andreasschoeler93/Stoppuhr-2.0-Ladekoffer/docs/Stoppuhr_2_0_Ladeplatine_Bestellliste.xlsx

Sheet: Reichelt-Bestellung
STOPPUHR 2.0 | LADEPLATINE · REICHELT
23 bestellbare Reichelt-Positionen • 10 Ladekanäle • Sonderbauteile stehen separat im Blatt »Noch offen«
Nr. | Reichelt-Artikel-Nr. | Anzahl | Bauteil / Artikel | KiCad-Referenz | Bauform / Raster | Hinweise zur Kompatibilität | Produktlink | Richtpreis €/Stk.* | Zwischensumme €*
1 | X7R-5 4,7N MUR | 10 | 4,7 nF, X7R, THT, RM 5,0 mm | C-DIV_1–10 | P5,0 / Scheibenkondensator | RM passt; maximale Breite/Dicke gegen D4,3 × W1,9 mm prüfen. | https://www.reichelt.de/de/de/shop/produkt/vielschicht-keramikkondensator_4_7n_10_-22871 | 0.10 € | 1.00 €
2 | RAD 100/25 | 1 | Elko 100 µF / 25 V, radial | C1 | D6,3 / H11 / P2,5 | Gehäuse 6,3 × 11 mm; Polung beim Einbau beachten. | https://www.reichelt.de/de/de/shop/produkt/elko_radial_100_f_25_v_rm_2_5_85_c_2000h_20_-15102 | 0.04 € | 0.04 €
3 | X7R-5 100N | 5 | 100 nF, X7R, THT, RM 5,0 mm | C3–C7 | P5,0 / Scheibenkondensator | 5 Stück zusammengefasst; Bauteilkörperbreite/Dicke prüfen. | https://www.reichelt.de/de/de/shop/produkt/vielschicht-kerko_100_nf_50_100_v_x7r_10_rm_5_0-22865 | 0.05 € | 0.25 €
4 | KS-A 4,7U 25 | 10 | Elko 4,7 µF / 25 V, 4 × 5 mm, P1,5 | C_BAT_1–10 | D4,0 / H5 / P1,5 | Abmessungen passen exakt; Polarität beachten. | https://www.reichelt.de/de/de/shop/produkt/elko_radial_4_7_f_25_v_rm_1_5_85_c_1000_h_20_-228282 | 0.25 € | 2.50 €
5 | LED 3MM ST RT | 1 | LED 3 mm, rot | D1 | LED_D3.0mm | LED-Farbe anhand LCSC C2286 als rot rekonstruiert; Anschlussbelegung kontrollieren. | https://www.reichelt.de/de/de/shop/produkt/led_3_mm_bedrahtet_rot_20_mcd_60_-6828 | 0.15 € | 0.15 €
6 | LED 3MM ST GE | 1 | LED 3 mm, gelb | D2 | LED_D3.0mm | LCSC C2287 gelb, Reichelt-Alternative THT. | https://www.reichelt.de/de/de/shop/produkt/led_3_mm_bedrahtet_gelb_32_mcd_60_-6830 | 0.15 € | 0.15 €
7 | LED 3MM ST GN | 1 | LED 3 mm, grün | D3 | LED_D3.0mm | LCSC C2289 ist gelbgrün; Ersatz leuchtet grün, Farbton abweichend. | https://www.reichelt.de/de/de/shop/produkt/led_3_mm_bedrahtet_gruen_32_mcd_60_-6829 | 0.13 € | 0.13 €
8 | 1N 5819 TSC | 1 | Schottky-Diode 1N5819, DO-41 | D5 | DO-41, P7,62 | Gehäuse passt; Kathodenrichtung beachten. | https://www.reichelt.de/de/de/shop/produkt/schottkydiode_40_v_1_a_do-41-219559 | 0.10 € | 0.10 €
9 | MPE 087-1-050 | 1 | Stiftleiste 1×50, 2,54 mm, teilbar | J1; J4/J6/.../J22; J3/J25; U1 | P2,54, 1-reihig | Benötigt 34 Pins: J1=2, STAT=10, AHT20=8, XIAO=14; 16 Pins übrig. XIAO Header selbst anlöten. | https://www.reichelt.de/de/de/shop/produkt/stiftleisten_2_54_mm_1x50_gerade-119891 | 0.88 € | 0.88 €
10 | MPE 087-2-006 | 1 | Stiftleiste 2×3, 2,54 mm | J2 | 2×3, P2,54 | 6 Kontakte (2-reihig). | https://www.reichelt.de/de/de/shop/produkt/stiftleisten_2_54_mm_2x03_gerade-119893 | 0.16 € | 0.16 €
11 | BC 337-40 DIO | 1 | BC337-40, NPN, TO-92 | Q1 | TO-92 Inline | BC337-40 pinout E-B-C gegen den KiCad-Footprint prüfen. | https://www.reichelt.de/de/de/shop/produkt/bipolartransistor_npn_45v_0_8a_0_625w_to-92-219126 | 0.04 € | 0.04 €
12 | 2N 7000 DIO | 10 | 2N7000, N-Kanal MOSFET, TO-92 | Q2–Q11 | TO-92 Inline | Pinfolge G/S/D im Datenblatt gegen Platinen-Footprint prüfen. | https://www.reichelt.de/de/de/shop/produkt/mosfet_n-ch_60v_0_200a_0_4w_to-92-219075 | 0.08 € | 0.80 €
13 | METALL 1,00K | 3 | Metallschicht 1 kΩ, 0207 | R1, R3, R6 | DIN0207, P7,62 | 0,6 W, 1%. | https://www.reichelt.de/de/de/shop/produkt/widerstand_metallschicht_1_00_kohm_0207_0_6_w_1_-11403 | 0.07 € | 0.21 €
14 | METALL 680 | 3 | Metallschicht 680 Ω, 0207 | R2, R4, R8 | DIN0207, P7,62 | 0,6 W, 1%. | https://www.reichelt.de/de/de/shop/produkt/widerstand_metallschicht_680_ohm_0207_0_6_w_1_-11942 | 0.07 € | 0.21 €
15 | METALL 4,70K | 2 | Metallschicht 4,7 kΩ, 0207 | R5, R7 | DIN0207, P7,62 | 0,6 W, 1%. | https://www.reichelt.de/de/de/shop/produkt/widerstand_metallschicht_4_70_kohm_0207_0_6_w_1_-11784 | 0.10 € | 0.20 €
16 | METALL 10,0K | 11 | Metallschicht 10 kΩ, 0207 | R9 + R_STAT_1–10 | DIN0207, P7,62 | 1+10 Stück zusammengefasst, 0,6 W, 1%. | https://www.reichelt.de/de/de/shop/produkt/widerstand_metallschicht_10_0_kohm_0207_0_6_w_1_-11449 | 0.07 € | 0.77 €
17 | METALL 100K | 21 | Metallschicht 100 kΩ, 0207 | R_BOT_1–10; R_BZ_B2; R_GPD_1–10 | DIN0207, P7,62 | 10+1+10 Stück zusammengefasst, 0,6 W, 1%. | https://www.reichelt.de/de/de/shop/produkt/widerstand_metallschicht_100_kohm_0207_0_6_w_1_-11458 | 0.07 € | 1.47 €
18 | METALL 2,20K | 1 | Metallschicht 2,2 kΩ, 0207 | R_BZ_B1 | DIN0207, P7,62 | 0,6 W, 1%. | https://www.reichelt.de/de/de/shop/produkt/widerstand_metallschicht_2_20_kohm_0207_0_6_w_1_-11584 | 0.14 € | 0.14 €
19 | METALL 100 | 10 | Metallschicht 100 Ω, 0207 | R_GS_1–10 | DIN0207, P7,62 | 0,6 W, 1%. | https://www.reichelt.de/de/de/shop/produkt/widerstand_metallschicht_100_ohm_0207_0_6_w_1_-11457 | 0.09 € | 0.90 €
20 | METALL 200K | 10 | Metallschicht 200 kΩ, 0207 | R_TOP_1–10 | DIN0207, P7,62 | Verfügbarkeit vor Auftrag prüfen; Reichelt-Artikel grundsätzlich gelistet. | https://www.reichelt.de/de/de/shop/produkt/widerstand_metallschicht_200_kohm_0207_0_6_w_1_-11610 | 0.07 € | 0.70 €
21 | XIAO ESP32C3 | 1 | Seeed Studio XIAO ESP32-C3 ohne Header | U1 | XIAO-ESP32C3-DIP | Die beiden 1×7-Stiftleisten selbst aus der 50er-Leiste ablängen/anlöten. | https://www.reichelt.de/de/de/shop/produkt/xiao_esp32c3_wifi_bt_ohne_header-358356 | 7.50 € | 7.50 €
22 | MCP 23017-E/SP | 2 | I²C Portexpander MCP23017, DIP-28 | U2, U5 | DIP-28, 7,62 mm | Wichtig: ausdrücklich E/SP, kein SOIC-28. | https://www.reichelt.de/de/de/shop/produkt/i_o-erweiterung_16bit_1_8_-_5v_seriell_i2c_dip-28-140074 | 1.85 € | 3.70 €
23 | 74HC 4051 | 2 | SN74HC4051N, DIL-16 | U3, U4 | DIP-16, 7,62 mm | 16-poliges THT-Gehäuse. | https://www.reichelt.de/de/de/shop/produkt/multi-_demultiplexer_8-ch_2_10_v_dil-16-3229 | 0.50 € | 1.00 €
* Richtpreise aus Produktseiten; kein verbindliches Angebot, Preisstaffeln und Versand nicht berücksichtigt. |  |  |  |  |  |  |  | Summe (ca.) | 23.00 €

Sheet: Noch offen
NOCH OFFEN | NICHT BLIND BESTELLEN
6 Baugruppen-/Bauteilgruppen, zusammen 24 Stück, bleiben bis zur mechanischen Bestätigung aus der Reichelt-CSV ausgeschlossen.
KiCad-Referenz | Anzahl | Benötigtes Bauteil | Footprint aus KiCad | Warum nicht im Warenkorb | Nächste Prüfung
BZ1 | 1 | Magnetischer Buzzer Kingstate KCG0601 | MagneticBuzzer_Kingstate_KCG0601 | Keinen elektrisch/mechanisch belegten Reichelt-Ersatz gefunden; Spannung, Bauhöhe und Pad-Abstand entscheidend. | Originaltyp / genaue Maße bestätigen.
C2 | 1 | 1 µF, Keramik THT | C_Disc_D3.0mm_W2.0mm_P2.50mm | Reichelt Z5U-5 1,0µ hat P5,0 mm statt benötigtem P2,5 mm; passt nicht ohne Anpassung. | 1 µF, P2,5 mm, Körper max. D3,0 × W2,0 mm nachweisen.
J5/J7/.../J23 | 10 | 3-poliger Magnetladekontakt | PinHeader_1x03_P2.3mm_Magnetlader | Sonder-Rastermaß P2,3 mm; keine normale 2,54-mm-Stiftleiste verwendbar. | Exakte Hersteller-Nr. bzw. Magnetlade-Originalbuchse.
J24 | 1 | AMASS XT30U-M / XT30-PCB-Anschluss | AMASS_XT30U-M_1x02_P5.0mm_Vertical | Kein exakt bestätigter Reichelt-Artikel. XT30U-M und XT30UPB-M sind unterschiedliche Bauformen. | Footprint-Maßskizze mit Herstellerzeichnung abgleichen.
M1–M10 | 10 | TP4056-Lademodul, 6 Pins | TP4056-Module | Reichelt DEBO3 3.7LI 1.0A hat 29×18 mm, aber Platinenbefestigung/Pinraster aus der BOM nicht verifizierbar. | Abmessungen des bisherigen Moduls + Loch-/Pinposition vergleichen.
SW1 | 1 | APEM MJTP1250, THT, 6 × 3,5 × H5 mm | SW_PUSH_1P1T_6x3.5mm_H5.0_APEM_MJTP1250 | Exakter Typ bei Reichelt nicht sicher nachgewiesen; SMD-Alternative wäre falsch. | Exakten THT-Taster MJTP1250 beschaffen oder THT-Ersatz bemaßen.
41 Testpunkte (TP1 … TP_VBAT_DIV_10) sind Kupferpads auf der Platine und müssen nicht mitbestellt werden.

Sheet: BOM-Abgleich
BOM-ABGLEICH | ORIGINALDATEI
Alle Positionen aus bom.csv; die LCSC-Spalte dient nur zur Rückverfolgung, nicht als Bestellgrundlage.
Original-Designator | Originalwert | Stück | Original-Footprint | LCSC (ungeprüft) | Zuordnung | Hinweis
BZ1 | Buzzer | 1 | MagneticBuzzer_Kingstate_KCG0601 |  | Offen – kein Import | Details: Blatt »Noch offen«.
C-DIV_1, C-DIV_10, C-DIV_2, C-DIV_3, C-DIV_4, C-DIV_5, C-DIV_6, C-DIV_7, C-DIV_8, C-DIV_9 | 4,7nF | 10 | C_Disc_D4.3mm_W1.9mm_P5.00mm | C1622 | In Reichelt-CSV | Artikel und Menge im Blatt »Reichelt-Bestellung«.
C1 | 100uF | 1 | C_Radial_D6.3mm_H11.0mm_P2.50mm | C1002 | In Reichelt-CSV | Artikel und Menge im Blatt »Reichelt-Bestellung«.
C2 | 1uF | 1 | C_Disc_D3.0mm_W2.0mm_P2.50mm | C1592 | Offen – kein Import | Details: Blatt »Noch offen«.
C3 | 100nF | 1 | C_Disc_D5.0mm_W2.5mm_P5.00mm | C1590 | In Reichelt-CSV | Artikel und Menge im Blatt »Reichelt-Bestellung«.
C4 | 100nF (U2) | 1 | C_Disc_D5.0mm_W2.5mm_P5.00mm | C1590 | In Reichelt-CSV | Artikel und Menge im Blatt »Reichelt-Bestellung«.
C5 | 100nF (U3) | 1 | C_Disc_D5.0mm_W2.5mm_P5.00mm | C1590 | In Reichelt-CSV | Artikel und Menge im Blatt »Reichelt-Bestellung«.
C6, C7 | 100nF (U4) | 2 | C_Disc_D5.0mm_W2.5mm_P5.00mm | C1590 | In Reichelt-CSV | Artikel und Menge im Blatt »Reichelt-Bestellung«.
C_BAT_1, C_BAT_10, C_BAT_2, C_BAT_3, C_BAT_4, C_BAT_5, C_BAT_6, C_BAT_7, C_BAT_8, C_BAT_9 | 4,7uF | 10 | C_Radial_D4.0mm_H5.0mm_P1.50mm | C1002 | In Reichelt-CSV | Artikel und Menge im Blatt »Reichelt-Bestellung«.
D1 | LED | 1 | LED_D3.0mm | C2286 | In Reichelt-CSV | Artikel und Menge im Blatt »Reichelt-Bestellung«.
D2 | LED | 1 | LED_D3.0mm | C2287 | In Reichelt-CSV | Artikel und Menge im Blatt »Reichelt-Bestellung«.
D3 | LED | 1 | LED_D3.0mm | C2289 | Reichelt-Ersatz | LCSC Farbton gelbgrün; Reichelt LED grün.
D5 | 1N5819 | 1 | D_DO-41_SOD81_P7.62mm_Horizontal |  | In Reichelt-CSV | Artikel und Menge im Blatt »Reichelt-Bestellung«.
J1 | BUZZ | 1 | PinHeader_1x02_P2.54mm_Vertical |  | In Reichelt-CSV | Artikel und Menge im Blatt »Reichelt-Bestellung«.
J10, J12, J14, J16, J18, J20, J22, J4, J6, J8 | STAT | 10 | PinHeader_1x01_P2.54mm_Vertical |  | In Reichelt-CSV | Artikel und Menge im Blatt »Reichelt-Bestellung«.
J11, J13, J15, J17, J19, J21, J23, J5, J7, J9 | Slot 2 | 10 | PinHeader_1x03_P2.3mm_Magnetlader |  | Offen – kein Import | Details: Blatt »Noch offen«.
J2 | LED Taster | 1 | PinHeader_2x03_P2.54mm_Vertical |  | In Reichelt-CSV | Artikel und Menge im Blatt »Reichelt-Bestellung«.
J24 | Conn_01x02_Pin | 1 | AMASS_XT30U-M_1x02_P5.0mm_Vertical |  | Offen – kein Import | Details: Blatt »Noch offen«.
J25, J3 | AHT20 | 2 | PinHeader_1x04_P2.54mm_Vertical |  | In Reichelt-CSV | Artikel und Menge im Blatt »Reichelt-Bestellung«.
M1, M10, M2, M3, M4_9, M5, M6, M7, M8, M9 | Conn_01x06_Pin | 10 | TP4056-Module |  | Offen – kein Import | Details: Blatt »Noch offen«.
Q1 | BC337 | 1 | TO-92_Inline |  | In Reichelt-CSV | Artikel und Menge im Blatt »Reichelt-Bestellung«.
Q10, Q11, Q2, Q3, Q4, Q5, Q6, Q7, Q8, Q9 | 2N7000 | 10 | TO-92_Inline |  | In Reichelt-CSV | Artikel und Menge im Blatt »Reichelt-Bestellung«.
R1, R3, R6 | 1kOhm | 3 | R_Axial_DIN0207_L6.3mm_D2.5mm_P7.62mm_Horizontal | C14676 | In Reichelt-CSV | Artikel und Menge im Blatt »Reichelt-Bestellung«.
R2, R4, R8 | 680Ohm | 3 | R_Axial_DIN0207_L6.3mm_D2.5mm_P7.62mm_Horizontal | C23228 | In Reichelt-CSV | Artikel und Menge im Blatt »Reichelt-Bestellung«.
R5, R7 | 4,7kOhm | 2 | R_Axial_DIN0207_L6.3mm_D2.5mm_P7.62mm_Horizontal | C25999 | In Reichelt-CSV | Artikel und Menge im Blatt »Reichelt-Bestellung«.
R9 | 10kOhm | 1 | R_Axial_DIN0207_L6.3mm_D2.5mm_P7.62mm_Horizontal | C15401 | In Reichelt-CSV | Artikel und Menge im Blatt »Reichelt-Bestellung«.
R_BOT_1, R_BOT_10, R_BOT_2, R_BOT_3, R_BOT_4, R_BOT_5, R_BOT_6, R_BOT_7, R_BOT_8, R_BOT_9 | 100kOhm | 10 | R_Axial_DIN0207_L6.3mm_D2.5mm_P7.62mm_Horizontal | C23137 | In Reichelt-CSV | Artikel und Menge im Blatt »Reichelt-Bestellung«.
R_BZ_B1 | 2,2kOhm | 1 | R_Axial_DIN0207_L6.3mm_D2.5mm_P7.62mm_Horizontal | C4190 | In Reichelt-CSV | Artikel und Menge im Blatt »Reichelt-Bestellung«.
R_BZ_B2, R_GPD_1, R_GPD_10, R_GPD_2, R_GPD_3, R_GPD_4, R_GPD_5, R_GPD_6, R_GPD_7, R_GPD_8, R_GPD_9 | 100kOhm | 11 | R_Axial_DIN0207_L6.3mm_D2.5mm_P7.62mm_Horizontal | C14675 | In Reichelt-CSV | Artikel und Menge im Blatt »Reichelt-Bestellung«.
R_GS_1, R_GS_10, R_GS_2, R_GS_3, R_GS_4, R_GS_5, R_GS_6, R_GS_7, R_GS_8, R_GS_9 | 100Ohm | 10 | R_Axial_DIN0207_L6.3mm_D2.5mm_P7.62mm_Horizontal | C22775 | In Reichelt-CSV | Artikel und Menge im Blatt »Reichelt-Bestellung«.
R_STAT_1, R_STAT_10, R_STAT_2, R_STAT_3, R_STAT_4, R_STAT_5, R_STAT_6, R_STAT_7, R_STAT_8, R_STAT_9 | 10kOhm | 10 | R_Axial_DIN0207_L6.3mm_D2.5mm_P7.62mm_Horizontal | C23137 | In Reichelt-CSV | Artikel und Menge im Blatt »Reichelt-Bestellung«.
R_TOP_1, R_TOP_10, R_TOP_2, R_TOP_3, R_TOP_4, R_TOP_5, R_TOP_6, R_TOP_7, R_TOP_8, R_TOP_9 | 200kOhm | 10 | R_Axial_DIN0207_L6.3mm_D2.5mm_P7.62mm_Horizontal | C149567 | In Reichelt-CSV | Artikel und Menge im Blatt »Reichelt-Bestellung«.
SW1 | SW_Push | 1 | SW_PUSH_1P1T_6x3.5mm_H5.0_APEM_MJTP1250 |  | Offen – kein Import | Details: Blatt »Noch offen«.
TP1, TP10, TP11, TP2, TP3, TP4, TP5, TP6, TP7, TP8, TP9, TP_STAT_1, TP_STAT_10, TP_STAT_2, TP_STAT_3, TP_STAT_4, TP_STAT_5, TP_STAT_6, TP_STAT_7, TP_STAT_8, TP_STAT_9, TP_VBAT_1, TP_VBAT_10, TP_VBAT_2, TP_VBAT_3, TP_VBAT_4, TP_VBAT_5, TP_VBAT_6, TP_VBAT_7, TP_VBAT_8, TP_VBAT_9, TP_VBAT_DIV_1, TP_VBAT_DIV_10, TP_VBAT_DIV_2, TP_VBAT_DIV_3, TP_VBAT_DIV_4, TP_VBAT_DIV_5, TP_VBAT_DIV_6, TP_VBAT_DIV_7, TP_VBAT_DIV_8, TP_VBAT_DIV_9 | TestPoint | 41 | TestPoint_Pad_D1.5mm |  | PCB-Pad – keine Bestellung | Testpunkt ist in der Platine integriert.
U1 | XIAO-ESP32-C3-DIP | 1 | XIAO-ESP32C3-DIP |  | In Reichelt-CSV | Artikel und Menge im Blatt »Reichelt-Bestellung«.
U2, U5 | MCP23017_SO | 2 | DIP-28_W7.62mm | C47023 | In Reichelt-CSV | Artikel und Menge im Blatt »Reichelt-Bestellung«.
U3, U4 | SN74HC4051N | 2 | DIP-16_W7.62mm | C5274825 | In Reichelt-CSV | Artikel und Menge im Blatt »Reichelt-Bestellung«.

Sheet: Anleitung
ANLEITUNG | REICHELT-WARENKORB
Zum Einlesen der beiliegenden CSV-Datei in »Meine Listen« bei Reichelt.
Schritt | Aktion | Wo / Datei | Beschreibung
01 | Einloggen | https://www.reichelt.de | Mit dem eigenen myreichelt-Konto anmelden.
02 | Meine Listen öffnen | https://www.reichelt.de | Im linken Menü »Meine Listen« aufrufen.
03 | CSV importieren | Datei: Reichelt_Import_Ladeplatine_Stoppuhr_2_0.csv | Neue Liste → importieren (csv) → Datei auswählen. Keine Überschrift, Semikolontrennung.
04 | Kontrolle | Reichelt-Schaltfläche »Prüfen« | Artikelnummern, Bestellmengen und die Live-Verfügbarkeit überprüfen.
05 | Liste übernehmen | Nach dem Import | Liste in den Warenkorb übernehmen; keine Bestellung automatisch ausgelöst.
06 | Fehlteile ergänzen | Blatt »Noch offen« | 6 Positionen fehlen bewusst. Ohne Originalmaß/Modulzeichnung nicht blind bestellen.
ACHTUNG: Die Original-LCSC-IDs enthalten falsche SMD-Teile und sogar falsche Werte. Für diese THT-Platine nicht nach LCSC-Nr. bestellen!
Quelle für CSV-Import: https://www.reichelt.com/de/en/shop/landingpage/01%20Reasons-1388
