andreasschoeler93/Stoppuhr-2.0-Ladekoffer/CHANGELOG.md

# Versionsverlauf – Ladekoffer-Controller

| Version | Datum | Änderung |
| --- | --- | --- |
| v0.7.25 | 2026-11-12 | INA226 mit R100-Shunt an I²C-Adresse 0x40: Gesamtstrom oder ungültiger Messzustand an den Pi (ab v0.41.10). Messbereich etwa ±0,819 A; keine Abschaltung oder Überstromschutz. |
| v0.7.24 | 2026-11-12 | Alle Taster per Pi-Oberfläche wecken: Dieselbe konfigurierte Sequenz wie beim langen Tastendruck wird gestartet und nach Abschluss bestätigt (Pi ab v0.41.9). |
| v0.7.23 | 2026-11-12 | WLAN: Verbindung alle 5 s erneut versuchen, ESP32-Energiesparen deaktivieren und Abbruchgrund, Signalstärke sowie Kanal in den Diagnoseringpuffer aufnehmen. Ladeplätze: Spannungswerte erzeugen keinen Überspannungsfehler mehr, da ein leerer Ausgang ebenfalls eine hohe Spannung anzeigen kann. |
| v0.7.22 | 2026-11-12 | Der erkannte 15-Sekunden-Druck am Quittiertaster wird am Koffer durch dreimaliges abwechselndes Blinken der roten und grünen LED bestätigt. Zusätzlich puffert der Koffer die letzten 24 Diagnoseereignisse und überträgt sie an den Pi. |
| v0.7.21 | 2026-11-11 | Taster aufwecken: Der Pi kann zusätzlich zur festen Pin-Zuordnung eine eigene Reihenfolge der Slots 1–10 übermitteln (Pi ab v0.41.4). |
| v0.7.20 | 2026-11-11 | Quittiertaster: 1,5 bis unter 15 s halten und loslassen weckt alle Taster; 15 s halten fordert den Pi auf, Taster ohne Rolle schlafen zu schicken (Pi ab v0.41.3). Ampel-LED-Ausgänge auf aktiv-low umgestellt. |
| v0.7.19 | 2026-11-11 | Spannungsverlauf: Bei WLAN- oder Pi-Ausfall puffert der Koffer bis zu eine Stunde Spannungsmessungen im RAM und liefert sie nach Wiederverbindung in Paketen zu je 60 Messungen an den Pi nach (Pi ab v0.41.2). Neustart oder Stromausfall löscht den Puffer; bei längerem Ausfall werden die ältesten Werte überschrieben. |
| v0.7.18 | 2026-11-11 | Korrigiert: `firmware.bin` war mit 1.315.280 Bytes (v0.7.16) bzw. 1.316.000 Bytes (v0.7.17) größer als eine Update-Partition (1.310.720 Bytes), der Pi lehnte den Upload mit „Die Firmware ist groesser als eine Update-Partition“ ab. Der Versionsvergleich beim Update nutzt kein `sscanf` mehr (spart rund 16 KB); die Datei hat nun 1.299.856 Bytes. v0.7.16 und v0.7.17 lassen sich deshalb nicht per WLAN einspielen, v0.7.18 enthält zusätzlich die Startkontakte beim Taster-Update aus v0.7.17. || v0.7.17 | 2026-11-11 | Taster-Update: Meldet der Pi (ab v0.36.0) `ota_hold_ms` > 0 in der Antwort auf `POST /api/charger`, schaltet der Koffer alle Startkontakte ein, solange diese Restzeit läuft (Einstellung im Dashboard, Standard 300 s), damit sich die Taster beim Update nicht ausschalten. Ein Weckablauf hat Vorrang, danach werden die Kontakte wieder gehalten. Bleibt die Meldung vom Pi aus, enden die Kontakte nach der zuletzt gemeldeten Restzeit. || v0.7.16 | 2026-11-06 | Anzeige nur noch mit sicher messbaren Werten: „lädt“ (rote LED des Lademoduls, `STAT`) und Überspannung; „Taster da“ und „voll“ lassen sich mit dem TP4056-Modul nicht erkennen (Ausgang liegt ohne Akku bei ca. 4 V). Aufgeräumt: `present` und `full` sind aus Firmware und Meldung entfernt, samt Konstanten und Heuristik. Neu je Slot `since_s` (Sekunden seit der letzten Änderung von „lädt“, `null` seit dem Start unverändert). Ampel grün = kein Fehler und kein Ladevorgang. Einzel-Wecken vom Pi (v0.6.0) bleibt erhalten. |
| v0.7.13 | 2026-11-06 | Korrigiert nach Abgleich mit dem Schaltplan V3: Die Start-Signale von `U5` sind nicht der Reihe nach auf die Slots verteilt (Slot 1..10 = GPB3, GPA4, GPB4, GPA3, GPB5, GPA2, GPB6, GPA1, GPB7, GPA0). Diese Zuordnung ist jetzt fest in der Firmware; die Pins aus dem Pi-Dashboard werden ignoriert (Impulslänge und Abstand gelten weiter). `STAT` liegt an der roten LED des Lademoduls (LED an = HIGH). |
| v0.7.7 | 2026-11-05 | Korrigiert: Die Magnet-Trigger laufen über je einen 2N7000 (Gate HIGH = MAG_TRIG gegen GND). Die Ausgänge von `U5` sind jetzt im Ruhezustand LOW und beim Wecken HIGH (vorher umgekehrt, dadurch startete der Taster sofort). Neu: Debug-Ausgaben im seriellen Monitor (`debug on/off`), LED-Test beim Start, Pieper stumm für alle Meldungen bei kurzem Druck auf `TRIG_ALL`, Befehle `wake <n>`, `wakeall on/off`, `wakepol low/high` (gespeichert), `pintest`, `i2c`. Update vom Pi spielt nur noch neuere Versionen ein. |
| v0.6.0 | 2026-11-03 | Einzelnes Wecken eines Ladeplatzes über das Dashboard: nutzt den für den Slot konfigurierten Magnet-Pin und Impuls; meldet den Abschluss per Request-ID an den Pi zurück. Der Status meldet zusätzlich, ob gerade ein Weckvorgang läuft. |
| v0.5.0 | 2026-10-31 | Zugangsdaten (WLAN, Pi-Adresse, Schlüssel) liegen jetzt im Flash (NVS): eine per USB mit `secrets.h` geflashte Version schreibt sie dorthin, eine fertige Release-Datei ohne `secrets.h` nutzt die gespeicherten Werte. Neuer GitHub-Workflow baut zu jedem Versions-Tag `firmware.bin` als Release; der Pi (ab v0.20.0) listet sie zur Auswahl und lädt sie selbst. Die erste Version mit NVS muss einmal per USB geflasht werden. |
| v0.4.0 | 2026-10-31 | Update per WLAN (OTA): Bietet der Pi eine andere Version an (Pi ab v0.19.0, Einstellungen → Ladekoffer-Firmware), lädt der Koffer sie, prüft die MD5-Summe und startet neu. Nach einem Fehlschlag neuer Versuch erst nach 5 Minuten. Die erste Version mit Update muss einmal per USB geflasht werden. |
| v0.3.0 | 2026-10-31 | Ton für Dashboard-Meldungen über den Pieper des Koffers: gelbe Meldung = kurzer Piepton, rote Meldung = langer Ton im festen Abstand. Vorgaben kommen vom Pi in der Antwort auf `POST /api/charger` (Pi ab v0.18.0); ohne frische Antwort (> 60 s) verstummt der rote Ton. |
| v0.2.0 | 2026-10-31 | Taster aufwecken: Quittiertaster `TRIG_ALL` lang halten (≥ 1,5 s) steuert die Magnet-Trigger an `U5` (0x21) der Reihe nach von Slot 1 bis 10 an (aktiv gegen GND, je 3 s, Abstand 1 s). Pins, Impulslänge und Abstand stellt man im Dashboard ein (Pi ab v0.17.0, Übergabe in der Antwort auf `POST /api/charger`). Kurzer Druck quittiert weiter den Pieper. Serieller Befehl `wake`. |
| v0.1.1 | 2026-10-30 | WLAN: Verbindungsversuche (mit Statuscode), Abbrüche und erfolgreiche Verbindung erscheinen im seriellen Monitor; es wird ausschließlich das Koffer-WLAN verwendet. |
| v0.1.0 | 2026-10-30 | Umstellung auf PlatformIO (XIAO ESP32-C3) und Modulaufbau. Neu: WLAN-Meldung an den Koffer-Pi (`POST /api/charger`). Korrigiert: Teilerfaktor 3,0 (200 k / 100 k) statt 2,0; AHT20 ohne Wartezeiten im `loop()`; MCP23017-Ausfall wird gemeldet und automatisch neu gestartet; Ampel wird auf die LED-Treiber des MCP23017 gespiegelt. |
