andreasschoeler93/Stoppuhr-2.0-Ladekoffer/docs/Ladekoffer Stoppuhr-2.0 V3.pdf

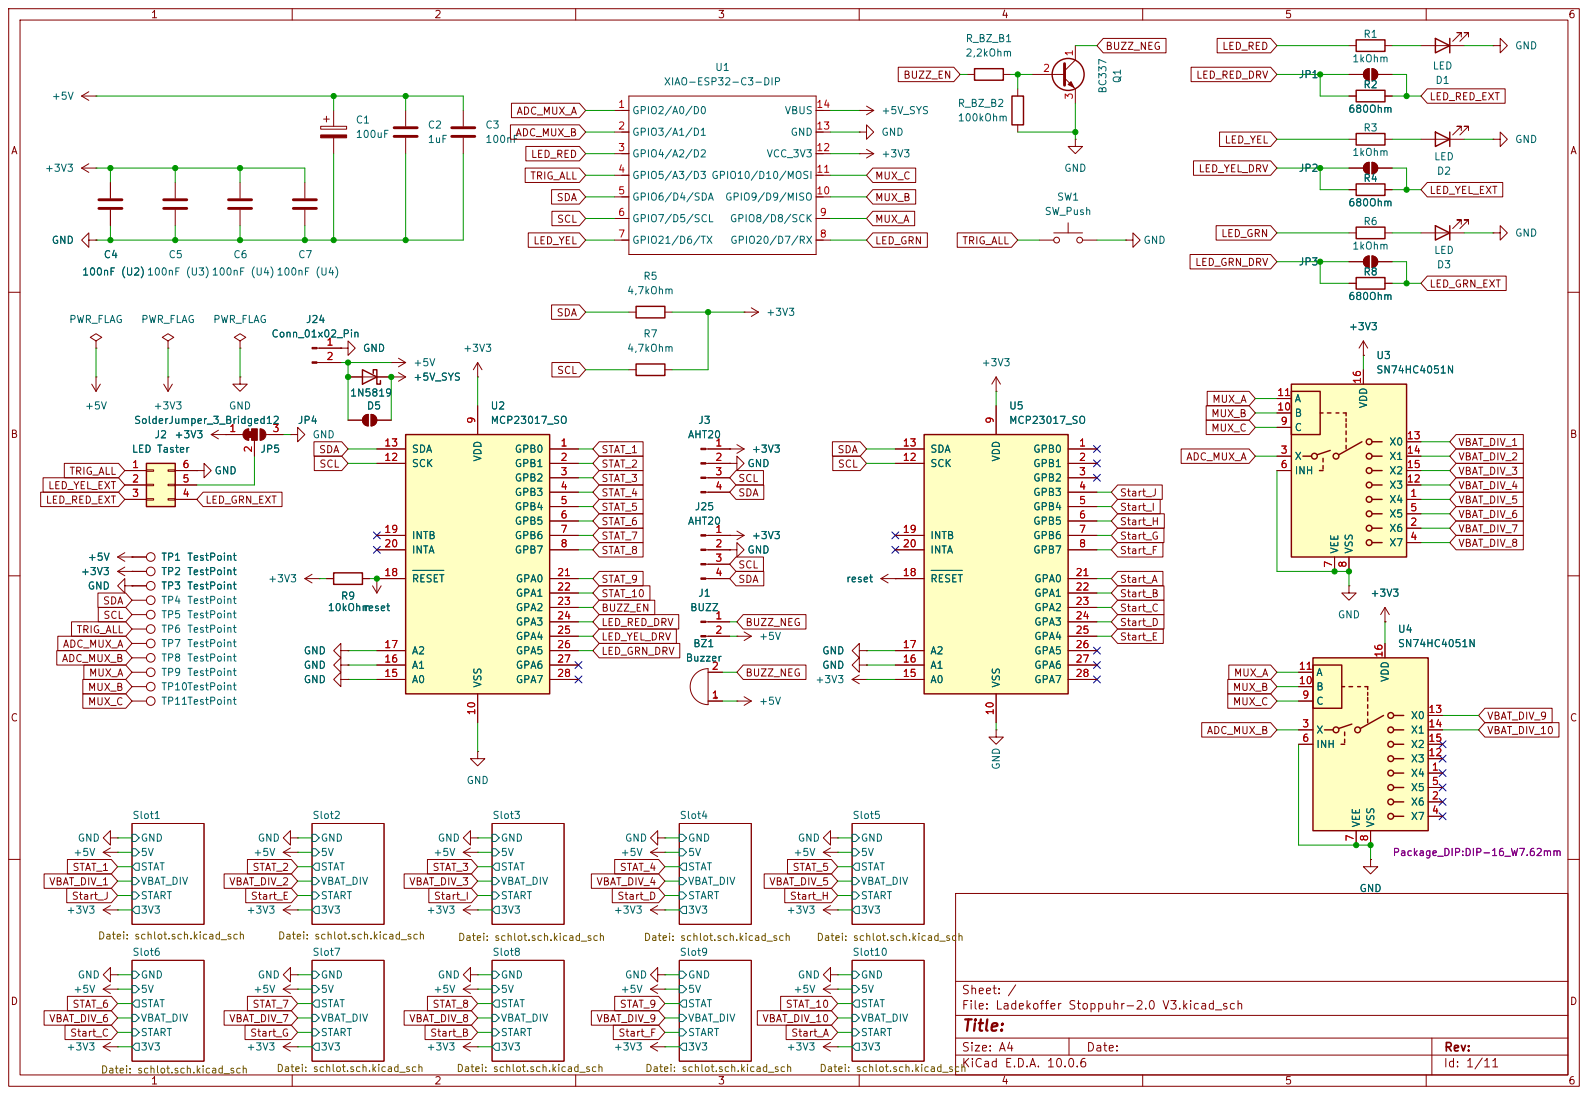
[picture p1: page 1]

TP2 TestPoint TP3 TestPoint TP1 TestPoint GND +5V +3V3

TP2 TestPoint TP3 TestPoint TP1 TestPoint TP6 TestPoint TP5 TestPoint TP4 TestPoint GND +5V

Slot1 Datei: schlot.sch.kicad_sch GND

Slot4 Datei: schlot.sch.kicad_sch GND

Slot3 Datei: schlot.sch.kicad_sch GND

Slot5 Datei: schlot.sch.kicad_sch GND

Slot9 Datei: schlot.sch.kicad_sch GND

Slot10 Datei: schlot.sch.kicad_sch GND

Size: A4 | Rev:
KiCad E.D.A. 10.0.6 | Id: 1/11

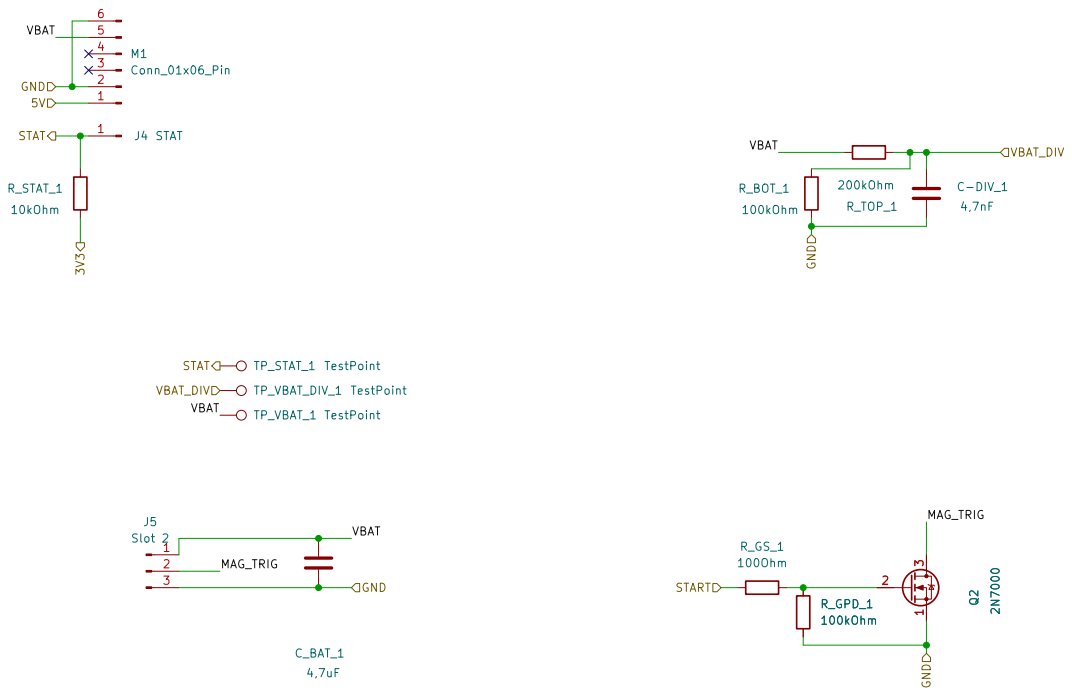
[picture p2: page 2]

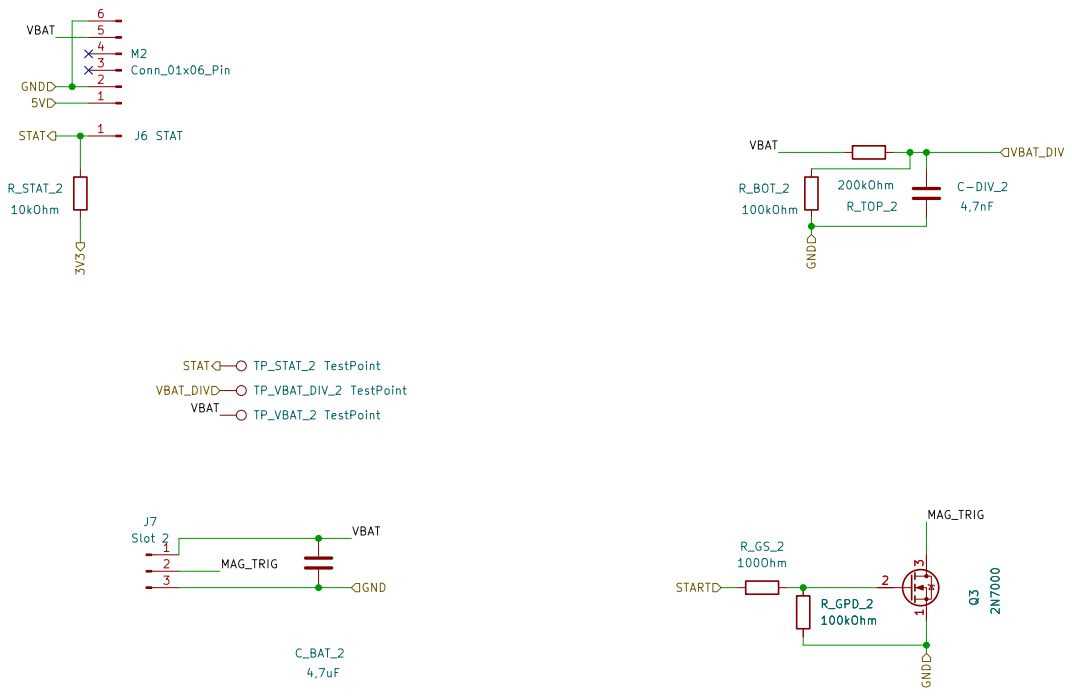
[picture p3: page 3]

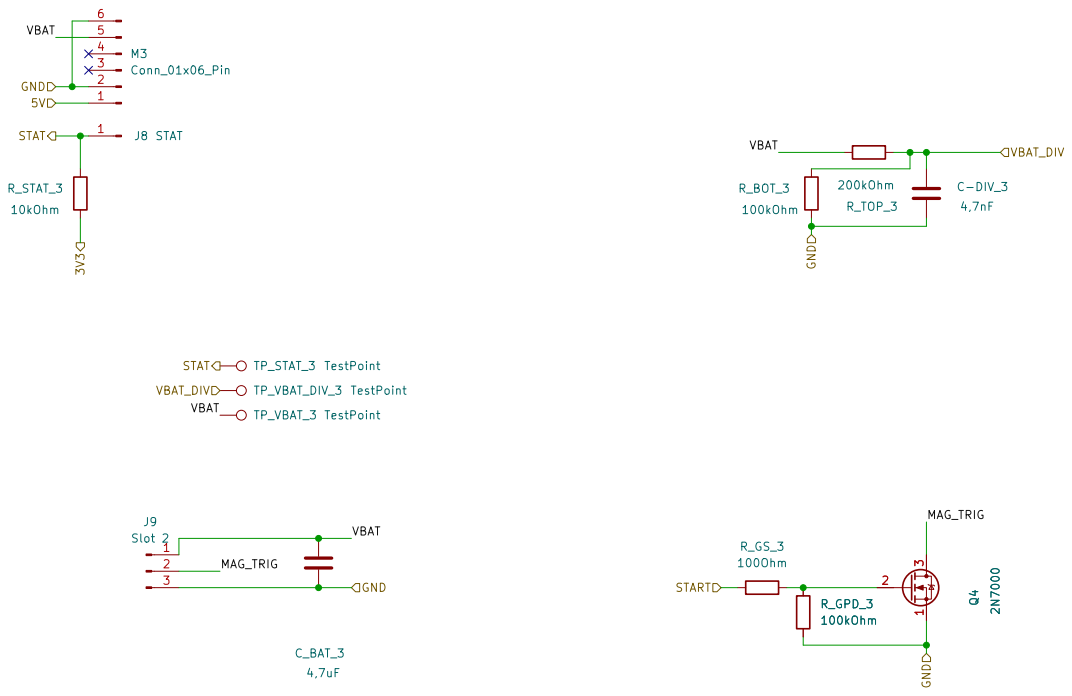
[picture p4: page 4]

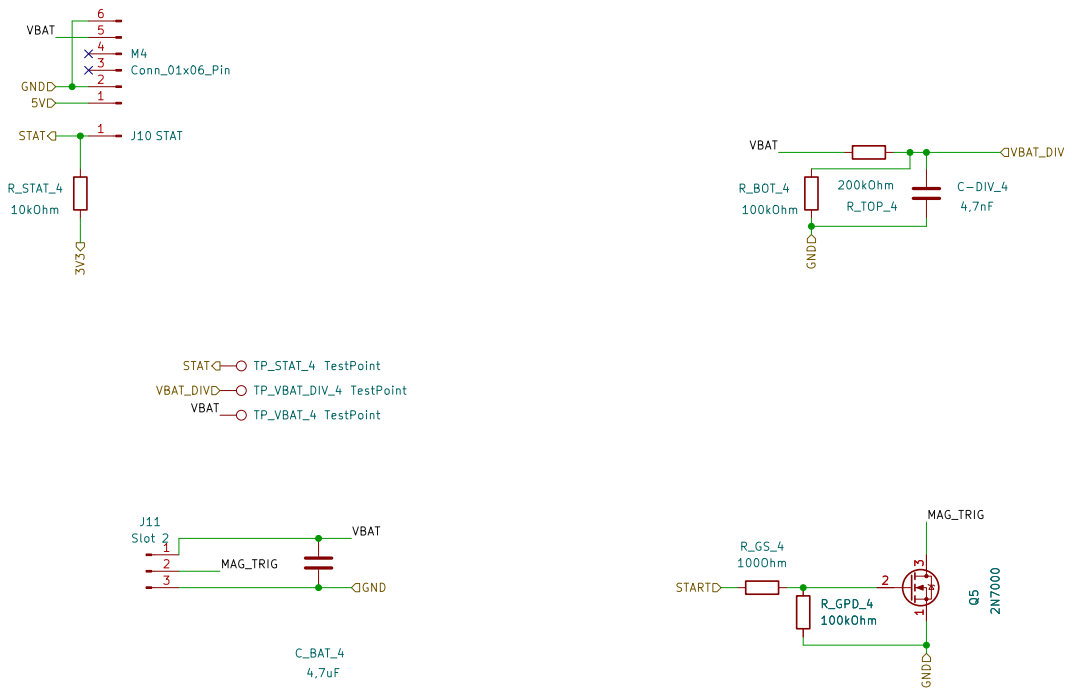
[picture p5: page 5]

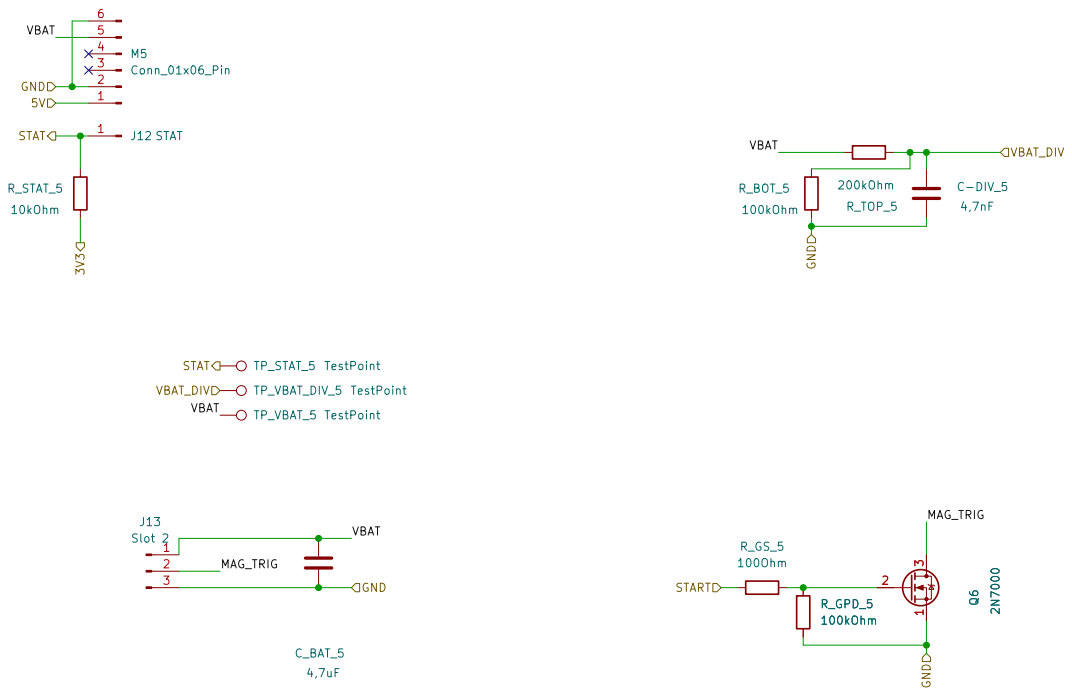
[picture p6: page 6]

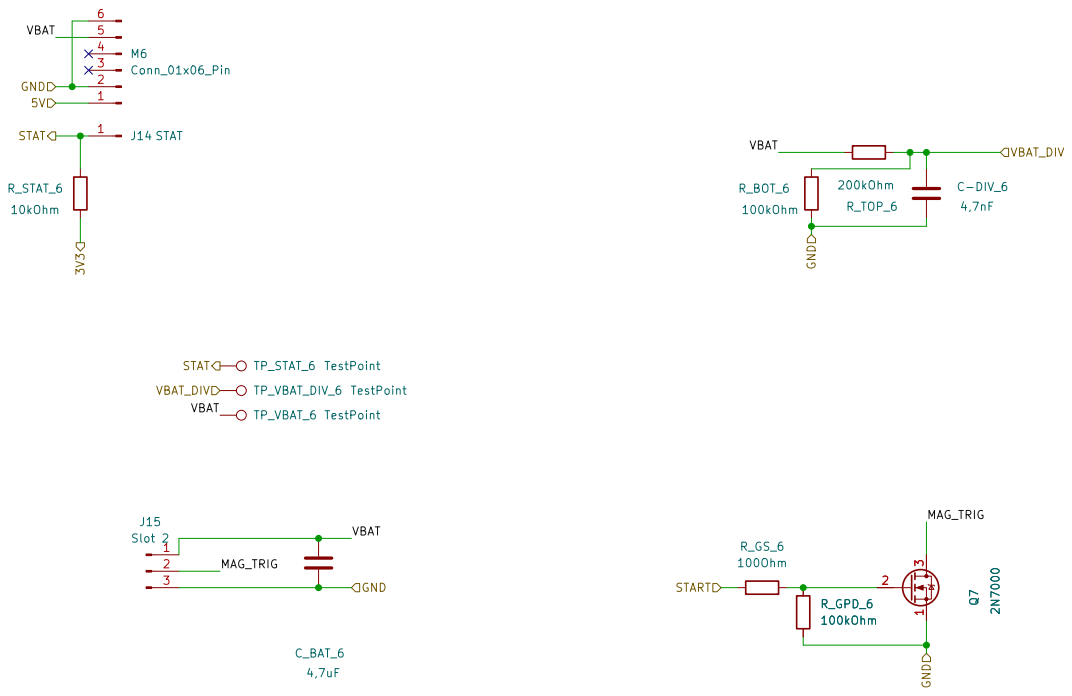
[picture p7: page 7]

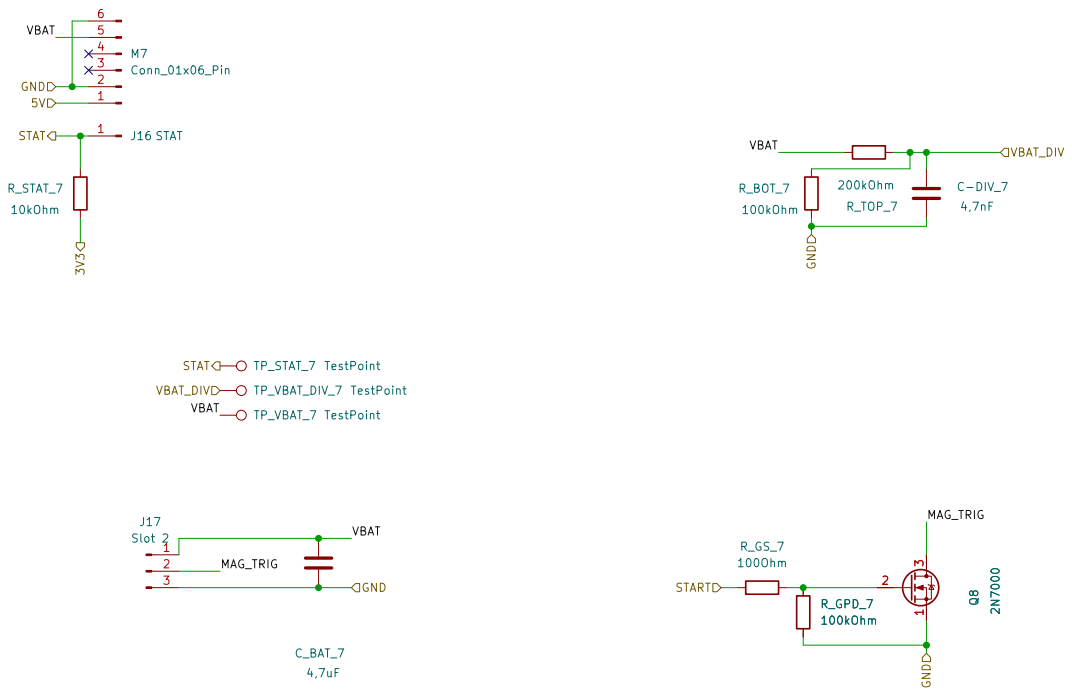
[picture p8: page 8]

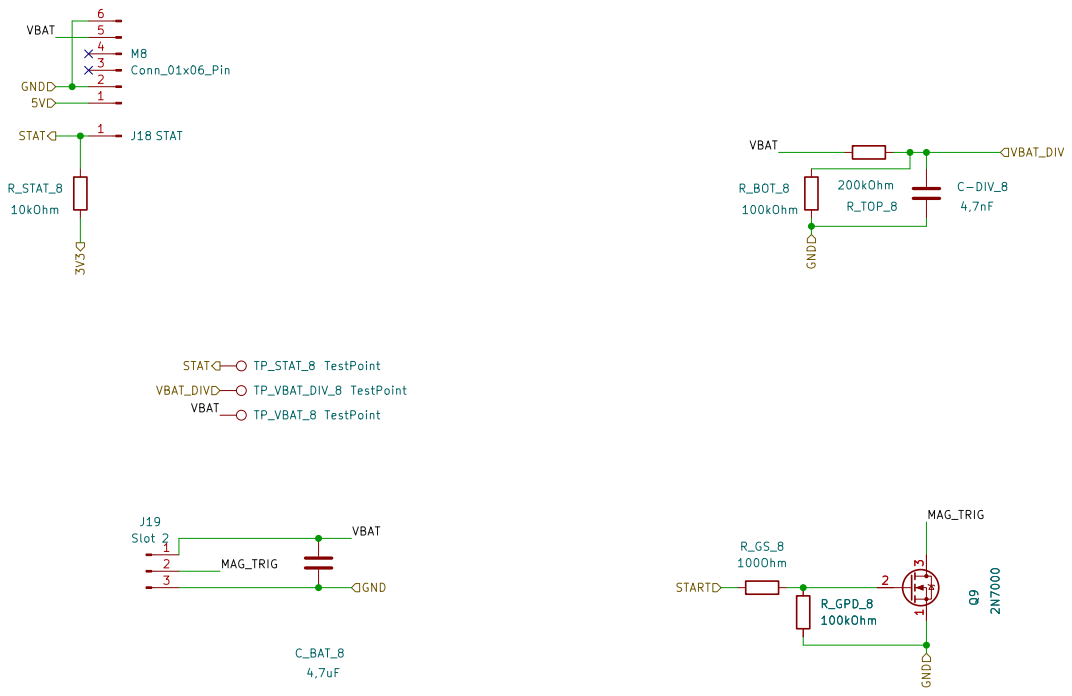
[picture p9: page 9]

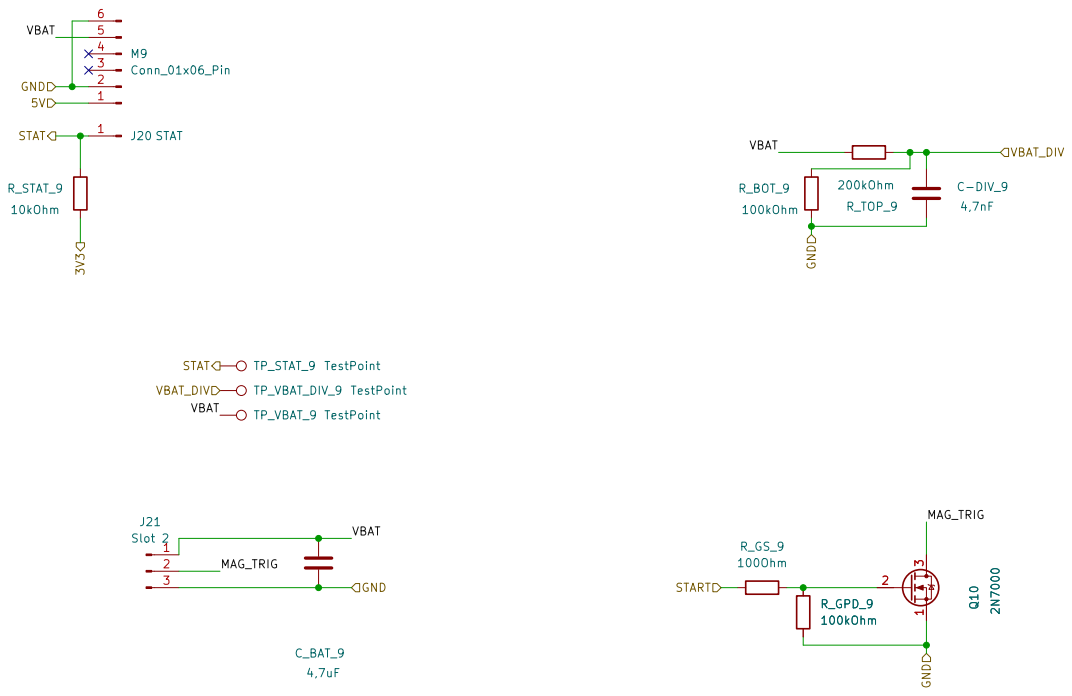
[picture p10: page 10]

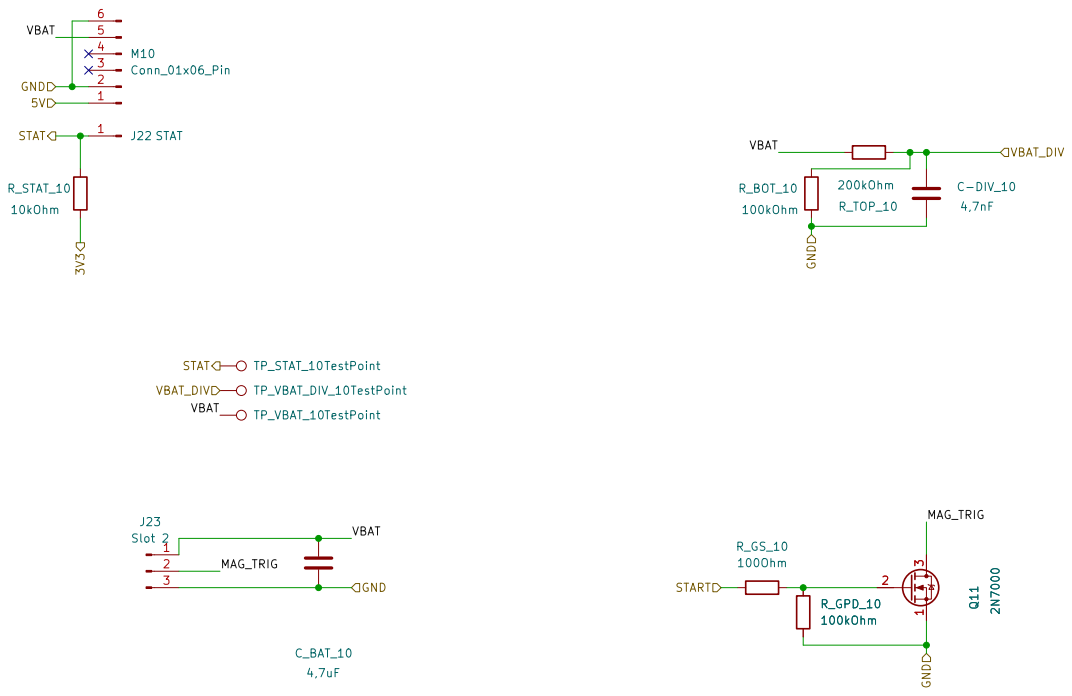
[picture p11: page 11]
