andreasschoeler93/Stoppuhr-2.0-Ladekoffer/src/wake.h

#pragma once

#include <Arduino.h>

#include "config.h"

// Weckt die Taster in der konfigurierten Slot-Reihenfolge. Jeder Magnet-Trigger
// bleibt pulseMs aktiv und startet gapMs nach dem vorherigen (die Impulse ueberlappen).
namespace wake {

struct Config {
  uint8_t pins[cfg::SLOT_COUNT];  // MCP23017-Pin (0..15) je Slot
  uint8_t order[cfg::SLOT_COUNT];  // Slotindex (0-basiert) je Weckposition
  uint16_t pulseMs;
  uint16_t gapMs;
};

Config defaults();
// Neue Werte vom Pi; wirkt ab dem naechsten Start, ein laufender Ablauf bleibt unveraendert
void configure(const Config& c);
// Polaritaet der Trigger-Ausgaenge umschalten und im Flash speichern (gilt auch nach dem Neustart)
void setActiveLow(bool low);
// Alle 16 Ausgaenge von U5 gleichzeitig auf aktiv oder Ruhe setzen (bleibt, bis zurueckgesetzt)
void setAll(bool on);
// Schaltet U5-Pin 0..15 nacheinander je 3 s ein, um die Zuordnung zu den Slots zu finden
void startPinTest();
void begin();
// Startet die Sequenz (ignoriert, solange eine laeuft); onlySlot 0..9 weckt nur diesen Slot
void start(int8_t onlySlot = -1);
// Slot 0 startet die gesamte Sequenz, 1..10 einen einzelnen Slot.
bool startRequest(uint8_t slot, const String& requestId);
bool active();
// Haelt alle Startkontakte aktiv (Taster-Update im Gange); danach zurueck auf Ruhe. Ein Weckablauf hat Vorrang.
void setHold(bool on);
String takeCompletedRequestId();
// Nicht blockierend im loop() aufrufen
void update();

}  // namespace wake
