andreasschoeler93/Stoppuhr-2.0-Ladekoffer/src/secrets.example.h

#pragma once

// Vorlage: nach src/secrets.h kopieren und eigene Werte eintragen.
// src/secrets.h steht in .gitignore und wird nicht hochgeladen.
// Das Koffer-WLAN ist der Zugangspunkt des Koffer-Pi (versteckt, SSID exakt eintragen).
#define SECRET_WIFI_SSID "Name-des-Koffer-WLAN"
#define SECRET_WIFI_PASS "WLAN-Passwort"
// Gemeinsame Adresse (VIP) der Pis im Taster-Netz
#define SECRET_PI_IP "192.168.50.10"
#define SECRET_API_KEY ""
