andreasschoeler93/Stoppuhr-2.0-Ladekoffer/(commit log)

2026-01-09 Update README with Ladekoffer Controller details
    Added detailed documentation for the Ladekoffer Controller firmware, including features, hardware specifications, pin mapping, dependencies, build instructions, configuration settings, and serial commands.
2026-01-09 Create wiring.md with TP4056 and button details
    Added wiring documentation for TP4056 and related components.
2026-01-09 Create troubleshooting.md with sensor fault solutions
    Added troubleshooting guide for common sensor issues and ADC problems.
2026-01-09 Add Ladekoffer Controller firmware
    Initial implementation of the Ladekoffer Controller for managing battery slots and monitoring temperature.
2026-10-31 Taster aufwecken per Magnet-Trigger bei langem Druck (v0.2.0)
2026-11-03 Add manual wake for individual charger slots
2026-11-11 v0.7.20: 15s Ausschalten und Ampelpolaritaet korrigieren
2026-11-12 Release Ladekoffer firmware v0.7.25
    Read INA226 current using the R100 shunt and report invalid measurements.
